cyberboy666/recurBOY/(notices)

Notices in the files:
hardware/recurBOY.kicad_sch:
CC-BY-SA
